misteraddons/Dreamcast-PopnMusic/KiCad/DC2JAMMA/DC2JAMMA.kicad_pcb

## KiCad design KiCad/DC2JAMMA/DC2JAMMA.kicad_pcb (2021-08-18)

Schematic: DC2JAMMA.sch

Parts:
D1, D2: BAT54S; D_SOT-23_ANK; LCSC Part C408389
J1, J3, J6, J7: Conn_01x02; PinHeader_1x02_P2.54mm_Vertical; LCSC Part C358684
J2, J4: Conn_01x05; TerminalBlock_RND_205-00015_1x05_P5.00mm_Horizontal; LCSC Part C192780
J5: Conn_02x20_Odd_Even; PinSocket_2x20_P2.54mm_Vertical; LCSC Part C429965
Logo1: MiSTer_Addons_Logo; MiSTer_Addons_copper_15mm
RN2, RN3, RN4, RN5, RN6, RN7: 10K_4xArray; R_Array_Convex_4x0402; LCSC Part C25725
U1, U2: Pico; RPi_Pico_SMD_TH
U3, U4, U5, U6, U7, U8: TVS_RCLAMP0524P-N; UDFN-10_1.35x2.6mm_P0.5mm; LCSC Part C316044

Connections:
+3V3: J5.3
+5V: J5.1, J5.2
/BLUE_IN: J5.9, J5.10
/COIN_METER_1: J5.4
/GREEN_IN: J5.7, J5.8
/P1A: J5.32, RN4.5 (R4.2), U6.1 (IO1), U6.10 (N/C)
/P1A_ATTEN: RN4.4 (R4.1), U2.10 (GPIO7)
/P1B: J5.34, RN4.7 (R2.2), U6.4 (IO3), U6.7 (N/C)
/P1B7: J5.11
/P1B8: J5.12
/P1B_ATTEN: RN4.2 (R2.1), U2.11 (GPIO8)
/P1C: J5.36, RN6.5 (R4.2), U8.1 (IO1), U8.10 (N/C)
/P1COIN: J5.14
/P1C_ATTEN: J1.1, RN6.4 (R4.1), U2.12 (GPIO9)
/P1DOWN: J5.20, RN5.5 (R4.2), U5.1 (IO1), U5.10 (N/C)
/P1DOWN_ATTEN: RN5.4 (R4.1), U2.5 (GPIO3)
/P1LEFT: J5.22, RN5.7 (R2.2), U5.4 (IO3), U5.7 (N/C)
/P1LEFT_ATTEN: RN5.2 (R2.1), U2.6 (GPIO4)
/P1LT_ATTEN: J3.2, U2.21 (GPIO16)
/P1RIGHT: J5.24, RN7.5 (R4.2), U7.1 (IO1), U7.10 (N/C)
/P1RIGHT_ATTEN: RN7.4 (R4.1), U2.7 (GPIO5)
/P1RT_ATTEN: J1.2, U2.22 (GPIO17)
/P1RX: U2.2 (GPIO1)
/P1START: J5.16, RN3.5 (R4.2), U3.1 (IO1), U3.10 (N/C)
/P1START_ATTEN: RN3.4 (R4.1), U2.9 (GPIO6)
/P1TX: U2.1 (GPIO0)
/P1UP: J5.18, RN3.7 (R2.2), U3.4 (IO3), U3.7 (N/C)
/P1UP_ATTEN: RN3.2 (R2.1), U2.4 (GPIO2)
/P1X: J5.26, RN7.7 (R2.2), U7.4 (IO3), U7.7 (N/C)
/P1X_ATTEN: RN7.2 (R2.1), U2.14 (GPIO10)
/P1Y: J5.28, RN2.5 (R4.2), U4.1 (IO1), U4.10 (N/C)
/P1Y_ATTEN: RN2.4 (R4.1), U2.15 (GPIO11)
/P1Z: J5.30, RN2.7 (R2.2), U4.4 (IO3), U4.7 (N/C)
/P1Z_ATTEN: J3.1, RN2.2 (R2.1), U2.16 (GPIO12)
/P1_ANALOG_HOR_1: U2.24 (GPIO18)
/P1_ANALOG_VER_1: U2.25 (GPIO19)
/P1_MAPLE_PIN1: J4.1, U2.19 (GPIO14)
/P1_MAPLE_PIN5: J4.5, U2.20 (GPIO15)
/P2A: J5.31, RN4.6 (R3.2), U6.2 (IO2), U6.9 (N/C)
/P2A_ATTEN: RN4.3 (R3.1), U1.10 (GPIO7)
/P2B: J5.33, RN4.8 (R1.2), U6.5 (IO4), U6.6 (N/C)
/P2B7: J5.37
/P2B8: J5.38
/P2B_ATTEN: RN4.1 (R1.1), U1.11 (GPIO8)
/P2C: J5.35, RN6.6 (R3.2), U8.2 (IO2), U8.9 (N/C)
/P2COIN: J5.13
/P2C_ATTEN: J6.1, RN6.3 (R3.1), U1.12 (GPIO9)
/P2DOWN: J5.19, RN5.6 (R3.2), U5.2 (IO2), U5.9 (N/C)
/P2DOWN_ATTEN: RN5.3 (R3.1), U1.5 (GPIO3)
/P2LEFT: J5.21, RN5.8 (R1.2), U5.5 (IO4), U5.6 (N/C)
/P2LEFT_ATTEN: RN5.1 (R1.1), U1.6 (GPIO4)
/P2LT_ATTEN: J7.2, U1.21 (GPIO16)
/P2RIGHT: J5.23, RN7.6 (R3.2), U7.2 (IO2), U7.9 (N/C)
/P2RIGHT_ATTEN: RN7.3 (R3.1), U1.7 (GPIO5)
/P2RT_ATTEN: J6.2, U1.22 (GPIO17)
/P2RX: U1.2 (GPIO1)
/P2START: J5.15, RN3.6 (R3.2), U3.2 (IO2), U3.9 (N/C)
/P2START_ATTEN: RN3.3 (R3.1), U1.9 (GPIO6)
/P2TX: U1.1 (GPIO0)
/P2UP: J5.17, RN3.8 (R1.2), U3.5 (IO4), U3.6 (N/C)
/P2UP_ATTEN: RN3.1 (R1.1), U1.4 (GPIO2)
/P2X: J5.25, RN7.8 (R1.2), U7.5 (IO4), U7.6 (N/C)
/P2X_ATTEN: RN7.1 (R1.1), U1.14 (GPIO10)
/P2Y: J5.27, RN2.6 (R3.2), U4.2 (IO2), U4.9 (N/C)
/P2Y_ATTEN: RN2.3 (R3.1), U1.15 (GPIO11)
/P2Z: J5.29, RN2.8 (R1.2), U4.5 (IO4), U4.6 (N/C)
/P2Z_ATTEN: J7.1, RN2.1 (R1.1), U1.16 (GPIO12)
/P2_ANALOG_HOR_1: U1.24 (GPIO18)
/P2_ANALOG_VER_1: U1.25 (GPIO19)
/P2_MAPLE_PIN1: J2.1, U1.19 (GPIO14)
/P2_MAPLE_PIN5: J2.5, U1.20 (GPIO15)
/RED_IN: J5.5, J5.6
GND: J2.3, J2.4, J4.3, J4.4, J5.39, J5.40, U1.3 (GND), U1.8 (GND), U1.13 (GND), U1.18 (GND), U1.23 (GND), U1.28 (GND), U1.38 (GND), U1.42 (GND), U2.3 (GND), U2.8 (GND), U2.13 (GND), U2.18 (GND), U2.23 (GND), U2.28 (GND), U2.38 (GND), U2.42 (GND), U3.3 (GND), U3.8 (GND), U4.3 (GND), U4.8 (GND), U5.3 (GND), U5.8 (GND), U6.3 (GND), U6.8 (GND), U7.3 (GND), U7.8 (GND), U8.3 (GND), U8.8 (GND)
unnamed: D1.1 (K), U1.39 (VSYS)
unnamed: D2.1 (K), U2.39 (VSYS)
VCC: D2.2 (A), J4.2
VDD: D1.2 (A), J2.2

Notes on the sheet:
ESD PROTECTION TVS DIODES AND RESISTORS

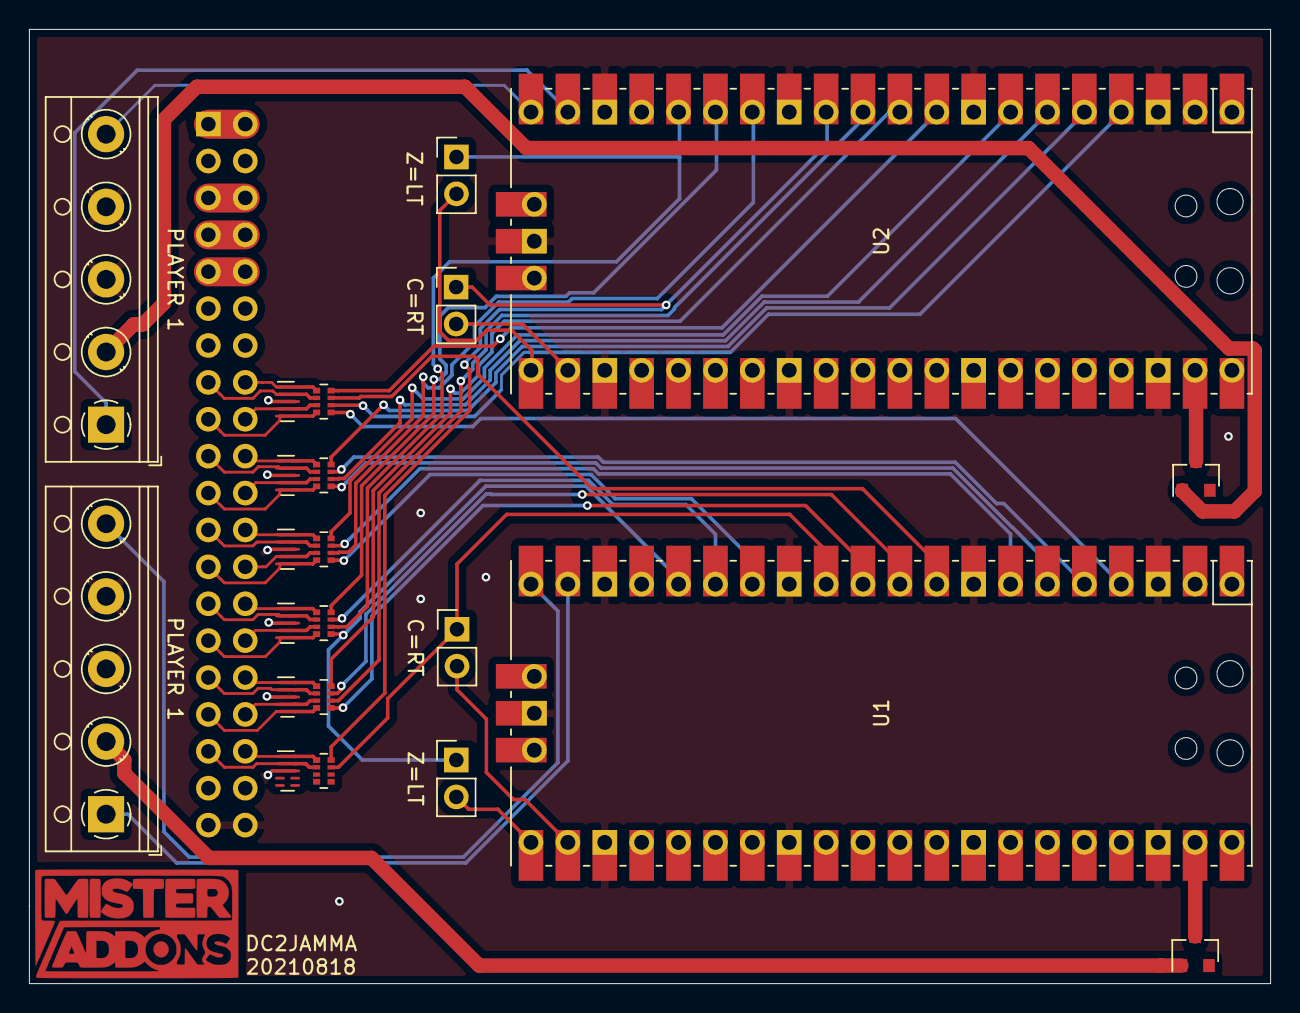
[picture p1: board DC2JAMMA.kicad_pcb from above]

Board: 2 copper layers, 85.4 x 65.7 mm, 24 parts (1 on the bottom side), 61 nets.
